WaratepBHN/ChronoDesk-PC-Project/README.md

# ChronoDesk

ChronoDesk is a smart desktop clock that brings time, weather information, and a Pomodoro timer together in a compact device for everyday study and work. Its dedicated display keeps essential information within sight, helping users check the time, monitor their surroundings, and follow focused work sessions while their computer is being used for other tasks.

The system is built around an ESP32-C3 Super Mini, a 0.96-inch ST7735 TFT display, and an SHT31 temperature and humidity sensor. It uses Wi-Fi to synchronize the clock through NTP and retrieve outdoor weather data from OpenWeatherMap, while the sensor measures indoor conditions. The current firmware includes four screens: animation, clock, weather, and a 25-minute work / 5-minute break Pomodoro timer, all controlled with a single push button.

The hardware is housed in a custom 3D-printed enclosure. This repository includes the firmware, display resources, circuit diagrams, enclosure STL files, and setup documentation to help others understand, assemble, and develop their own version of ChronoDesk.

### Website
https://waratepbhn.github.io/ChronoDesk-PC-Project/

### VDO
https://youtu.be/xJjyy5MB8Cg?si=4JZR6Z6MDQ1oD-sn

### [Hardware folder](./Hardware/)
This folder contains the hardware design and documentation for the ChronoDesk device, including the enclosure design and circuit diagrams.





### [Software folder](./Software/)
This folder contains the firmware source code, display resources, and program logic for the ChronoDesk system.




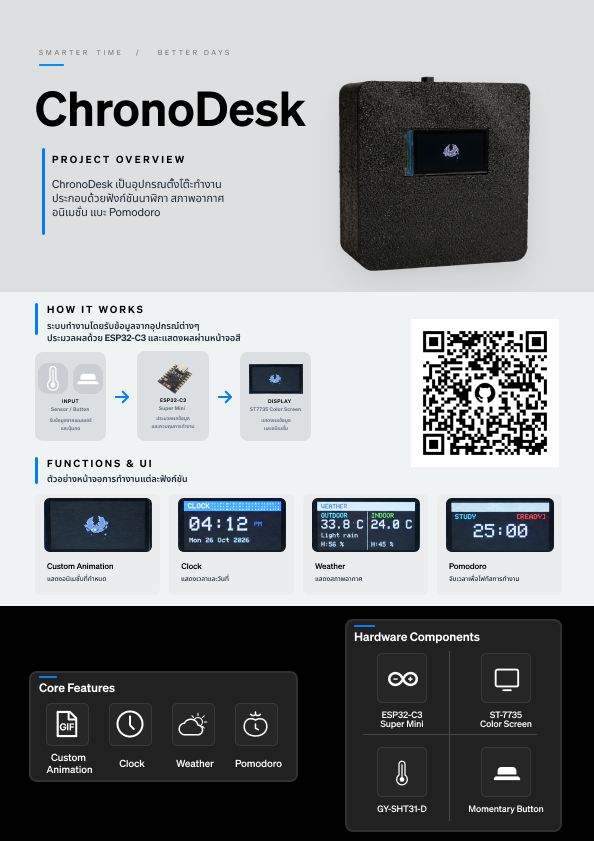
[picture p1: assets/images/poster.png]
Poster


## Contributors

| ID | Name | Role | Img |
| --- | --- | --- | --- |
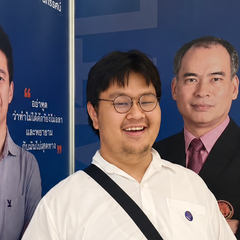
[picture p2: assets/images/waratep.jpg]
Waratep
| 68070169 | นายวราเทพ ภานนท์ | Hardware Dev |  |
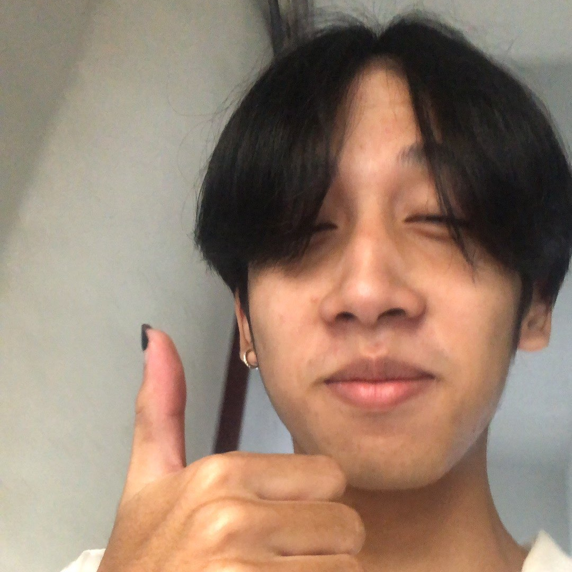
[picture p3: assets/images/supawit.png]
Supawit
| 68070179 | นายศุภวิชญ์ สุขจันทร์ | Software Dev |  |

## Present 06016409 PHYSICAL COMPUTING
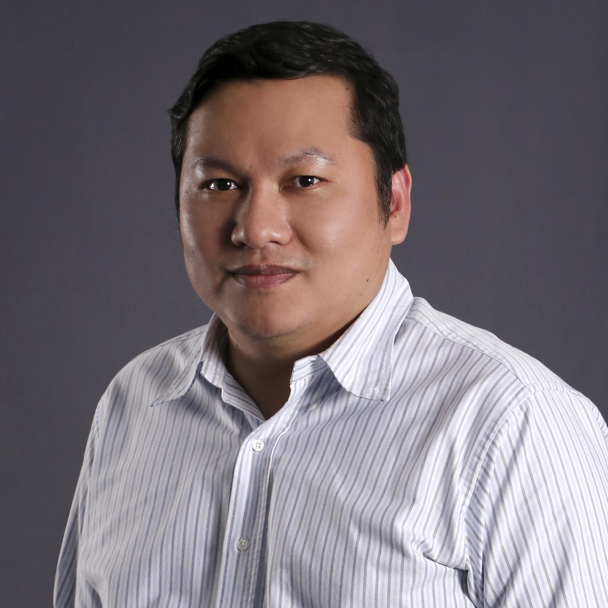
[picture p4: assets/images/panwit.jpg]
panwit

รองศาสตราจารย์ ดร. ปานวิทย์ ธุวะนุติ
