WaratepBHN/ChronoDesk-PC-Project/Web/assets/downloads/circuit-diagram.png

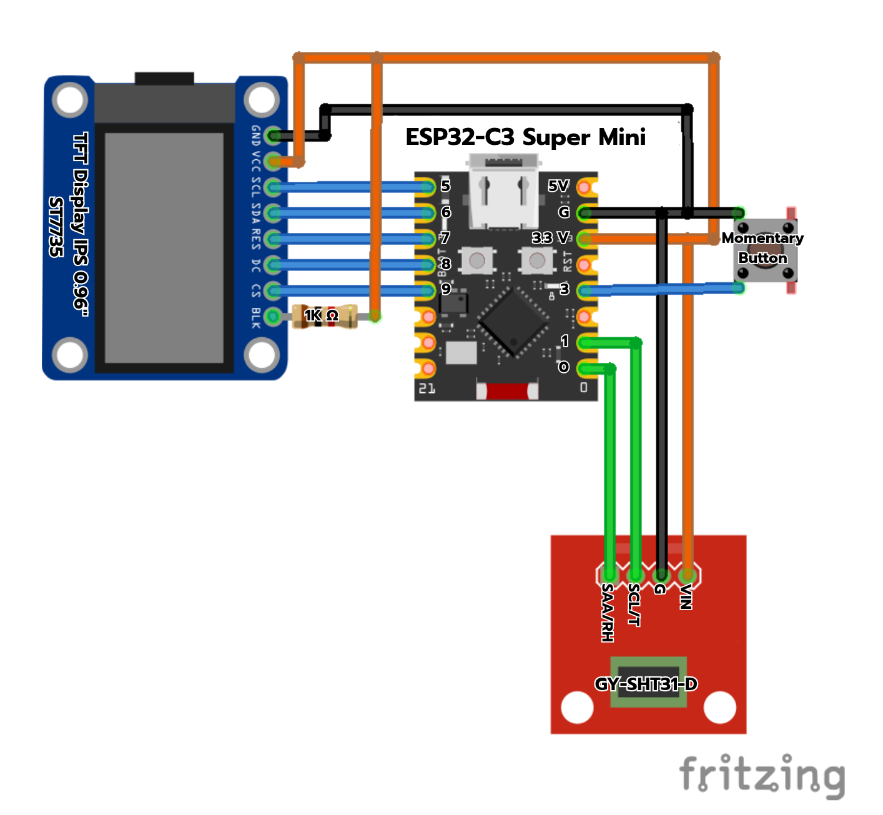
Web/assets/downloads/circuit-diagram.png
