WaratepBHN/ChronoDesk-PC-Project/Web/assets/images/hero.webp

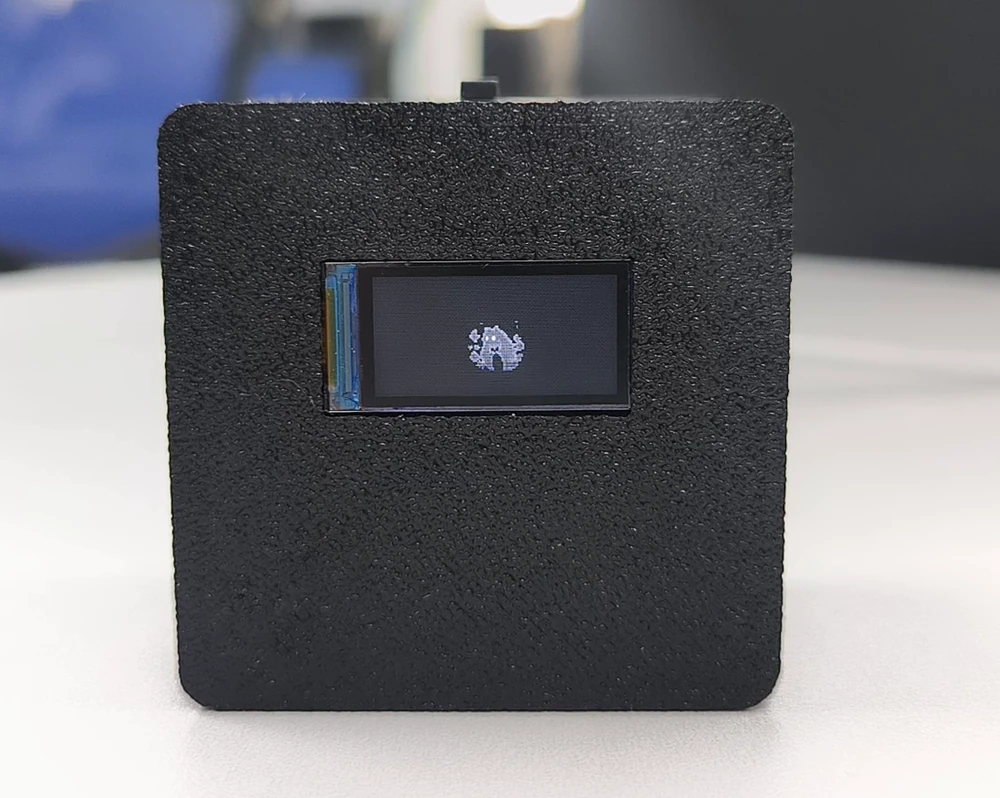
Web/assets/images/hero.webp
