WaratepBHN/ChronoDesk-PC-Project/Web/assets/images/mode-clock.webp

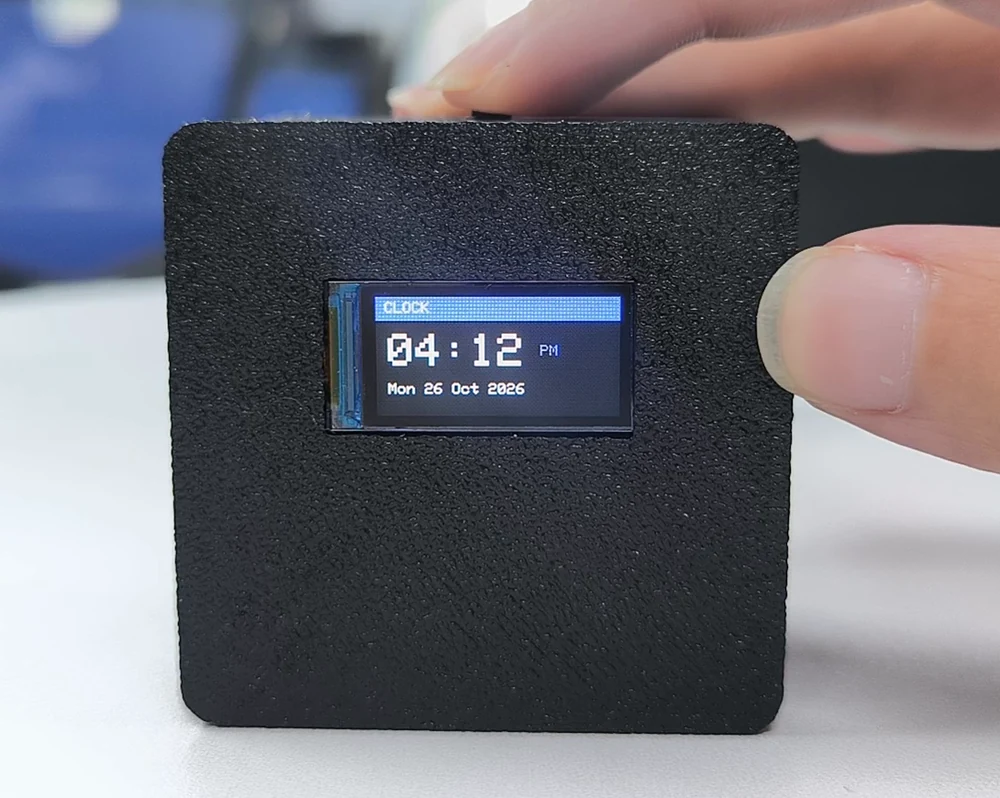
Web/assets/images/mode-clock.webp
