WaratepBHN/ChronoDesk-PC-Project/Web/assets/images/mode-pomodoro.webp

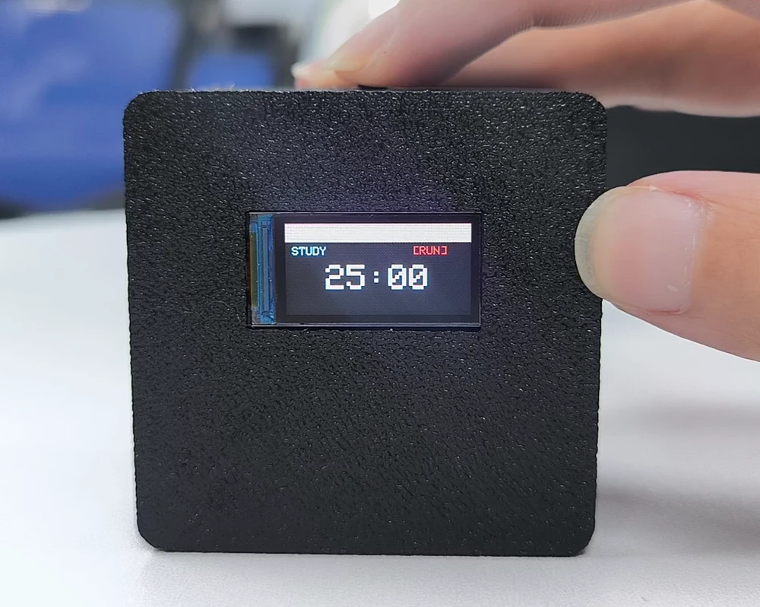
Web/assets/images/mode-pomodoro.webp
