WaratepBHN/ChronoDesk-PC-Project/Web/assets/images/social-cover.png

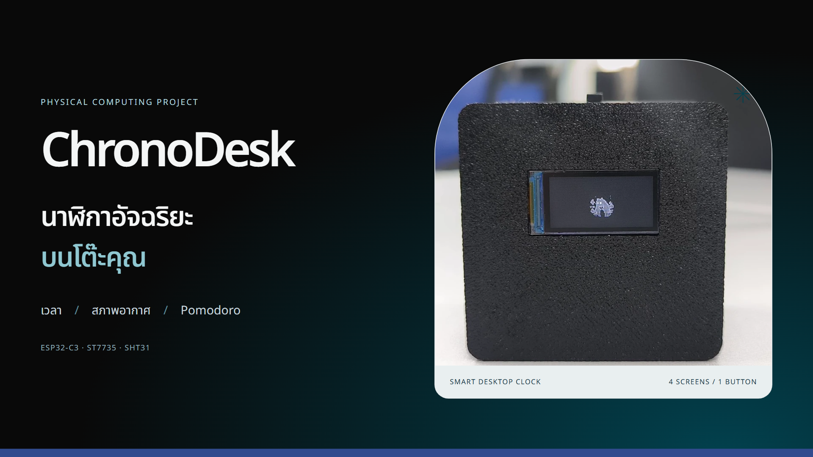
Web/assets/images/social-cover.png
