WaratepBHN/ChronoDesk-PC-Project/Web/assets/downloads/front.stl

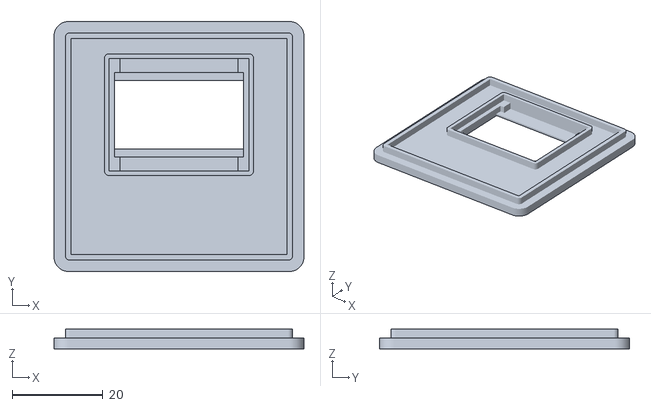
[picture p10: CAD file, 2026-10-22]
Web/assets/downloads/front.stl
55.0 x 55.0 x 4.40
