WaratepBHN/ChronoDesk-PC-Project/Web/assets/downloads/support.stl

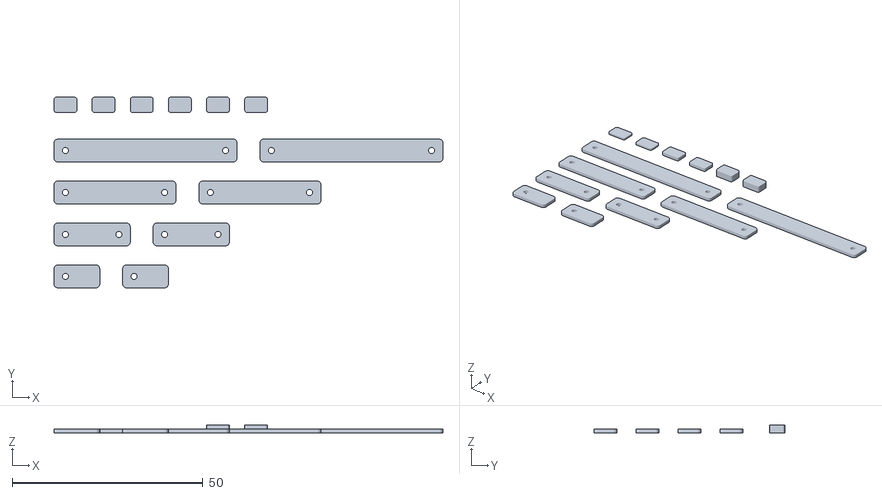
[picture p11: CAD file, 2026-10-22]
Web/assets/downloads/support.stl
102.0 x 50.0 x 2.00
