WaratepBHN/ChronoDesk-PC-Project/Web/assets/downloads/rear.stl

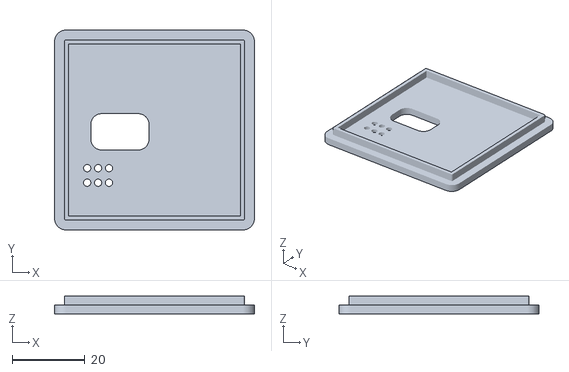
[picture p12: CAD file, 2026-10-22]
Web/assets/downloads/rear.stl
55.0 x 55.0 x 4.90
