WaratepBHN/ChronoDesk-PC-Project/Web/assets/downloads/body.stl

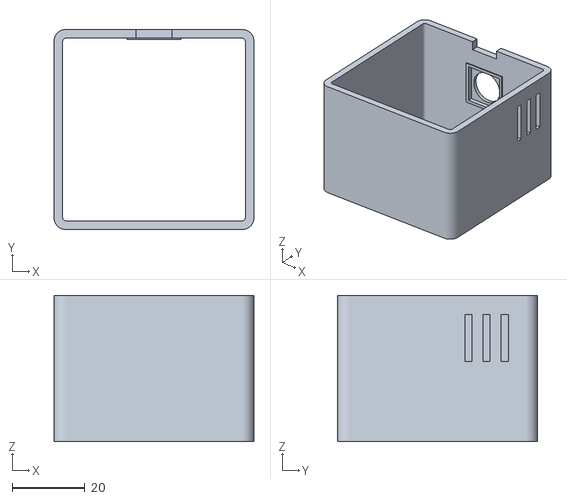
[picture p13: CAD file, 2026-10-22]
Web/assets/downloads/body.stl
55.0 x 55.0 x 40.2
