WaratepBHN/ChronoDesk-PC-Project/(list of files, drawings)

Other design files:
Web/assets/downloads/ChronoDesk_Diagram.fzz
