WaratepBHN/ChronoDesk-PC-Project/Web/assets/downloads/Guide.md

# คู่มือพิมพ์และปรับแก้เคส ChronoDesk

เคสที่พิมพ์ใช้งานจริงใช้ **eSUN PLA+ สีดำ ขนาดเส้น 1.75 mm** กับ **Bambu Lab A1 mini หัวฉีด 0.4 mm** โดยปรับอุณหภูมิฐานเป็น **60°C**

## ไฟล์ในโฟลเดอร์นี้

ขนาดด้านล่างเป็นขนาดภายนอกของแต่ละไฟล์ หน่วย mm ใช้ Scale **100%**

| ไฟล์ | ชิ้นส่วน / ขนาด | ท่าวางที่แนะนำ | Support |
| --- | --- | --- | --- |
| [front.stl](front.stl) | ฝาหน้า 55 × 55 × 4.4 | ผิวด้านนอกแบนลงฐาน ให้ร่องรับจอและขอบประกบหงายขึ้นด้านบน | ไม่มี |
| [body.stl](body.stl) | ตัวเคส 55 × 55 × 40.2 | ขอบด้านหน้าลงฐาน ตั้งสูง 40.2 mm | Tree (auto) |
| [rear.stl](rear.stl) | ฝาหลัง 55 × 55 × 4.9 | ผิวด้านนอกแบนลงฐาน ให้ขอบประกบหงายขึ้นด้านบน | ไม่มี |
| [support.stl](support.stl) | ชุดแถบยึดและแผ่นรอง 14 ชิ้น พื้นที่รวม 102 × 50 × 2 | วางแบนทุกชิ้น พิมพ์แบบ By layer | ไม่มี |

**support.stl คือชิ้นพลาสติกสำหรับช่วยยึดอุปกรณ์ภายในเคส** ส่วน Support ที่รองรับส่วนลอยระหว่างพิมพ์ ให้โปรแกรม Slicer สร้างเพิ่มตามการตั้งค่าของ body.stl

## เส้นพลาสติก

| เส้นพลาสติก | เหมาะกับงานแบบไหน | หัวฉีด | ฐาน | ใช้กับ A1 mini |
| --- | --- | --- | --- | --- |
| [eSUN PLA+](https://www.esun3d.com/pla-pro-product) | ชิ้นงานทั่วไป พิมพ์ได้ง่าย เป็นเส้นที่ใช้กับงานนี้จริง | 210–230°C | 45–60°C | เหมาะ เริ่มที่ 220 / 60°C |
| [Bambu Lab PETG HF](https://store.bblcdn.com/ce12d65176a94f1086e6aefa238e62e2.pdf) | เหนียวและทนความร้อนมากกว่า PLA | 230–260°C | 65–75°C | เหมาะ เลือกโปรไฟล์ Bambu PETG HF ให้ตรงเครื่อง |

- **PLA+:** ใช้โปรไฟล์ eSUN PLA+ ที่พิมพ์ผ่านแล้วเป็นหลัก ให้โปรไฟล์จัดการพัดลมในช่วงชั้นแรก
- **PETG HF:** ใช้โปรไฟล์ของรุ่นเส้นให้ตรง A1 mini หัว 0.4 mm อย่าคัดลอกความเร็วของ PLA มาใช้ เอกสารผู้ผลิตระบุพัดลม 0–60% และการใช้กาวบน PEI ให้ทำตามคำแนะนำของเส้นและแผ่นฐานจริงที่ใช้

### ถ้าเส้นชื้น

หากมีเสียงแตกขณะฉีด เส้นมีฟอง หรือใยมากผิดปกติ ให้ตรวจเรื่องความชื้นร่วมกับอุณหภูมิและการตั้งค่า ใช้เครื่องอบเส้นและตรวจว่าม้วนทนอุณหภูมิได้

| รุ่นเส้น | ค่าการอบจากผู้ผลิต |
| --- | --- |
| eSUN PLA+ | 50°C นาน 8–12 ชั่วโมง เมื่อจำเป็นต้องอบ |
| Bambu PETG HF | 65°C นาน 8 ชั่วโมง แนะนำให้อบก่อนใช้ |

หลังใช้เก็บเส้นในถุงหรือกล่องปิดพร้อมสารดูดความชื้น

## โปรแกรมเตรียมพิมพ์

แนะนำ **[Bambu Studio](https://bambulab.com/en/download/studio)**

หากต้องการเครื่องมือปรับเทียบเพิ่มเติม สามารถใช้ [OrcaSlicer](https://www.orcaslicer.com/) ได้ โดยเลือกโปรไฟล์เครื่อง หัวฉีด และฐานให้ตรงก่อน Slice

## ค่าตั้งต้นสำหรับเคสนี้ด้วย eSUN PLA+

| รายการใน Bambu Studio | ค่าที่แนะนำ |
| --- | --- |
| Printer / Nozzle | Bambu Lab A1 mini / 0.4 mm Standard |
| Plate | Textured PEI Plate เมื่อเป็นแผ่นชนิดนี้ |
| Filament | eSUN PLA+ ขนาด 1.75 mm |
| Nozzle temperature | Initial layer 220°C / Other layers 220°C |
| Textured PEI bed temperature | Initial layer 60°C / Other layers 60°C |
| Process | 0.20 mm Standard @BBL A1M |
| Layer height / Initial layer height | 0.20 / 0.20 mm |
| Wall loops | 3 |
| Top / Bottom shell layers | 5 / 5 |
| Sparse infill | 15–20% แบบ Gyroid |
| ความเร็วเริ่มต้น | Initial layer 20–30 mm/s, Outer wall ประมาณ 60 mm/s; ส่วนอื่นเริ่มจากโปรไฟล์วัสดุ |
| Scale | 100% ทุกแกน |
| Ironing / Raft layers | ปิด / 0 |
| Brim | เริ่มจากปิด หากขอบตัวเคสยกจึงลอง Outer brim 5 mm |
| Print sequence | By layer |

สำหรับ **support.stl ชุดแถบยึด** ให้ตั้ง Sparse infill เป็น **100% เฉพาะชิ้นนี้** ผ่าน Objects ส่วนตัวเคสใช้ค่าด้านบนได้ โดยไม่ต้องเปลี่ยนทั้งงานเป็น 100%

### ตั้ง Support ให้ตัวเคส

1. เลือก **body.stl** ในแท็บ **Objects → Support** แล้วเปิด **Enable support**
2. เลือก **Type: tree (auto)** และ **On build plate only** เริ่มจาก Threshold angle 30° แล้ว Slice
3. ใน Preview เลือก **Color Scheme: Line Type** ตรวจว่ามีรายการ **Support / Support interface** และมีส่วนรองรับตรงเพดานรูปุ่มหรือช่องที่ต้องการ
4. เลื่อนดูชั้นพิมพ์บริเวณนั้น หากยังไม่มีส่วนรองรับที่ต้องการ ให้ใช้ Support painting บังคับเฉพาะผิวล่างของบริเวณนั้นแล้ว Slice ใหม่ การเปิด Enable support อย่างเดียวอาจยังไม่สร้าง Support หากโปรแกรมมองว่าเป็นสะพานที่พิมพ์ได้
5. ฝาหน้า ฝาหลัง และชุดแถบยึดให้ปิด Support แยกตามชิ้น ไม่จำเป็นต้องเติม Support เต็มโพรงเคส

## ก่อนส่งพิมพ์

1. ตรวจเครื่องจริง หัวฉีด แผ่นฐาน และเส้นให้ตรงกับโปรไฟล์ จากนั้น Arrange ให้ชิ้นงานไม่ซ้อนกัน
2. กด **Slice plate** แล้วตรวจ Preview ทั้งชั้นแรก รูจอ รูปุ่ม ขอบประกบ และ Support
3. พิมพ์ชิ้นทดสอบก่อนเมื่อเปลี่ยนวัสดุหรือแก้ไข แม้ชื่อวัสดุเหมือนกัน ความพอดีอาจเปลี่ยนเมื่อเปลี่ยนรุ่นเส้นหรือเครื่อง
4. เมื่อเริ่มพิมพ์ ดูว่าชั้นแรกติดฐานและไม่มีเส้นถูกลากไปมา หากผิดปกติให้หยุดตรวจ ก่อนปล่อยให้พิมพ์ต่อ
5. พิมพ์เสร็จรอฐานเย็นแล้วค่อยยกแผ่นออกมาดัดเบา ๆ ใช้ Scraper อย่างเบามือเมื่อจำเป็น จากนั้นแกะ Support และลองประกอบ

## ถ้าอยากแก้ขนาดหรือรูปร่างเอง

### แก้ง่ายผ่านเว็บ: Tinkercad

ใช้ **[Tinkercad](https://www.tinkercad.com/)** สำหรับเพิ่มรู ขยายรู ตัดช่อง หรือเพิ่มส่วนรองรับเล็ก ๆ

1. สร้างงานใหม่ → **Import STL** → ใช้หน่วย mm และ Scale 100%
2. วาง **Ruler** เพื่อดูมิติและระยะ ใช้ **Box / Cylinder** กำหนดส่วนที่จะเพิ่มหรือเจาะ
3. หากต้องการเจาะ ให้เปลี่ยนชิ้นตัวตัดเป็น **Hole** จัดตำแหน่งด้วย **Align** แล้วเลือกทั้งโมเดลและตัวตัด → **Union Group (Ctrl+G)**
4. Export เป็น STL ชื่อใหม่ แล้วเปิดใน Bambu Studio เพื่อตรวจขนาดและ Slice ใหม่
