WaratepBHN/ChronoDesk-PC-Project/(commit log)

2026-10-22 Fix Image
    [ChronoDesk_Diagram.fzz, body.stl, front.stl, rear.stl, support.stl]
2026-10-22 Add เสนอ
2026-10-27 Add bilingual ChronoDesk project website and GitHub Pages deployment
    [ChronoDesk_Diagram.fzz, body.stl, front.stl, rear.stl, support.stl]
